lewuq/DJ_Music_Controller/hardware/enclosure_20mm/lower_case_TEST_FIT.stl

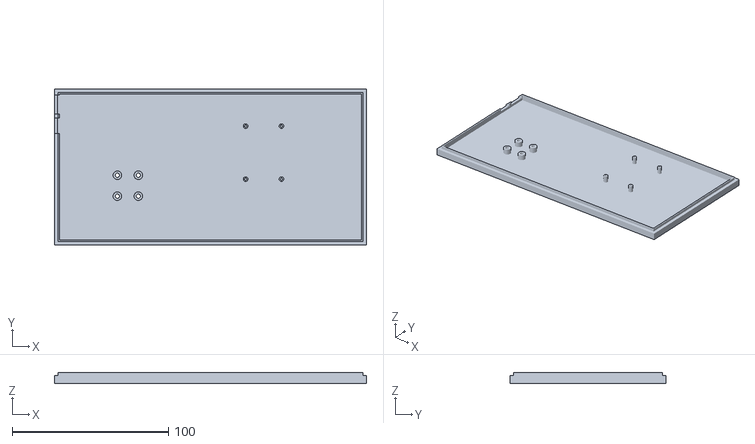
[picture p1: CAD file, 2026-10-30]
hardware/enclosure_20mm/lower_case_TEST_FIT.stl
200.0 x 100.0 x 7.00
