lewuq/DJ_Music_Controller/hardware/enclosure_20mm/upper_case_TEST_FIT.stl

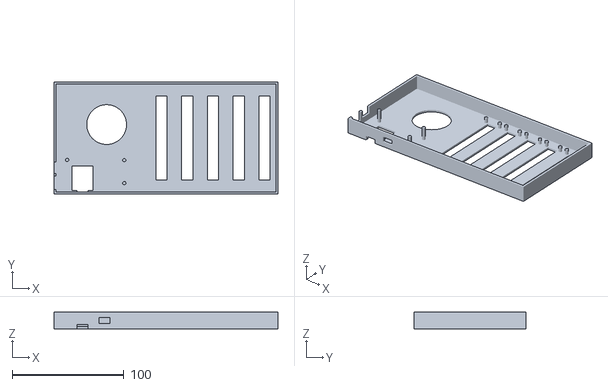
[picture p2: CAD file, 2026-10-30]
hardware/enclosure_20mm/upper_case_TEST_FIT.stl
200.0 x 100.0 x 15.0
