lewuq/DJ_Music_Controller/hardware/enclosure_20mm/test_fit_layout.png

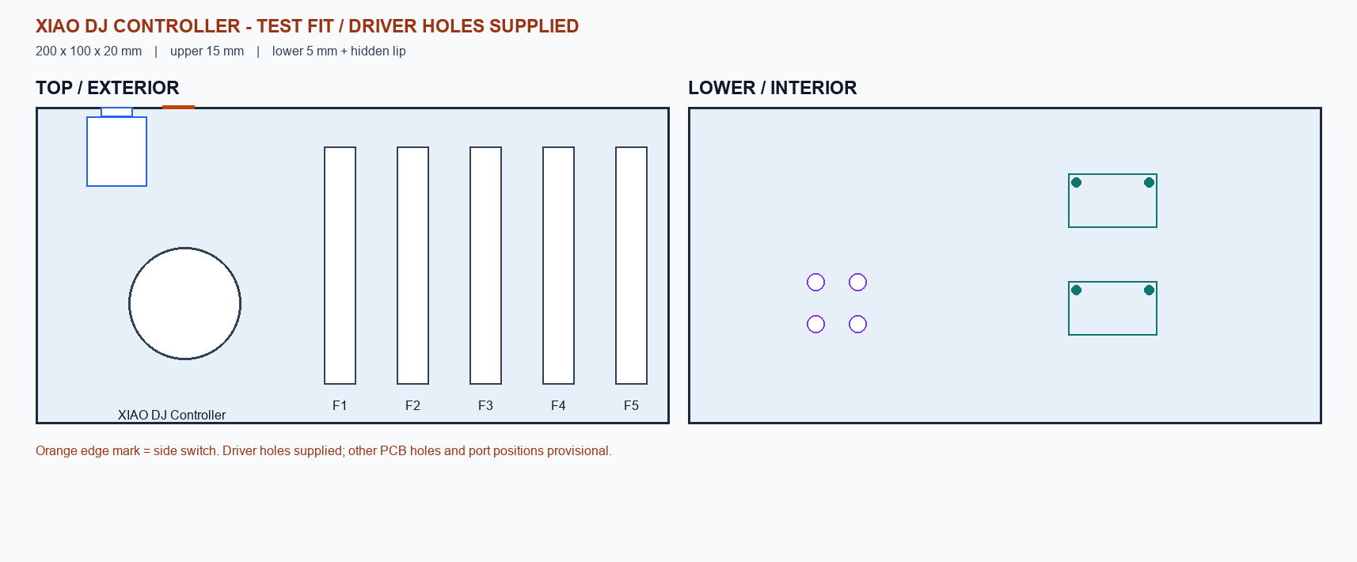
hardware/enclosure_20mm/test_fit_layout.png
