lewuq/DJ_Music_Controller/(commit log)

2026-10-28 Add motor-driven audio controls and CAN autorun
2026-10-30 Add 20 mm DJ controller enclosure models
    [lower_case_TEST_FIT.stl, upper_case_TEST_FIT.stl]
